ronanmmurphy/Football-Heading-System/Images/graph_activity.png

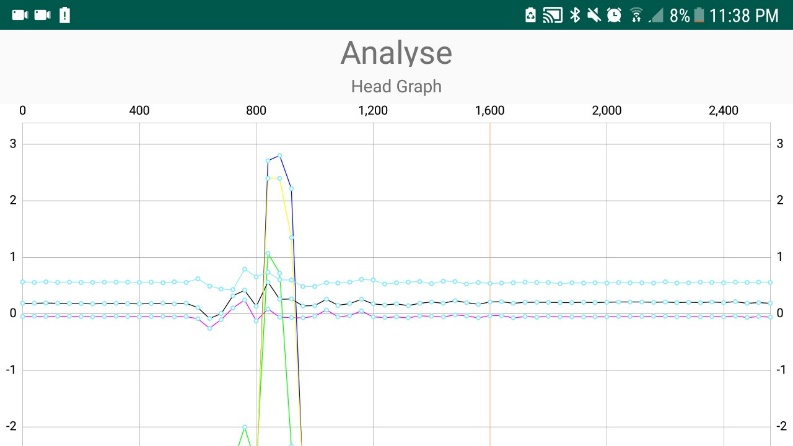
Images/graph_activity.png
