ronanmmurphy/Football-Heading-System/(commit log)

2021-01-15 Microprocessor Code
    Arduino Microprocessors for Head and Ball
2021-01-15 Machine Learning Model
    Labelled 180 test heading events and trained supervised learning sequential time-series model.
    [HeadData1.csv, HeadData10.csv, HeadData100.csv, HeadData101.csv, HeadData102.csv, HeadData103.csv, HeadData104.csv, HeadData105.csv]
